arjunjono/ByteForge/ByteForge_A1_EasyEDA_DRC_Pass.png

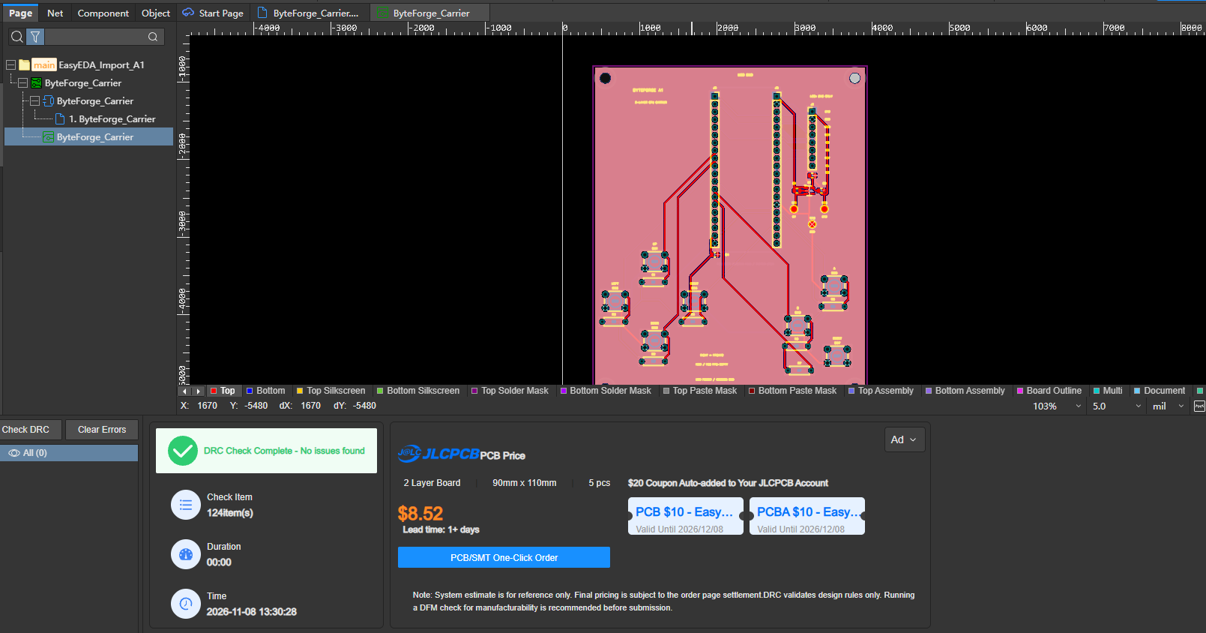
ByteForge_A1_EasyEDA_DRC_Pass.png
