arjunjono/ByteForge/ByteForge_E0_Preview.png

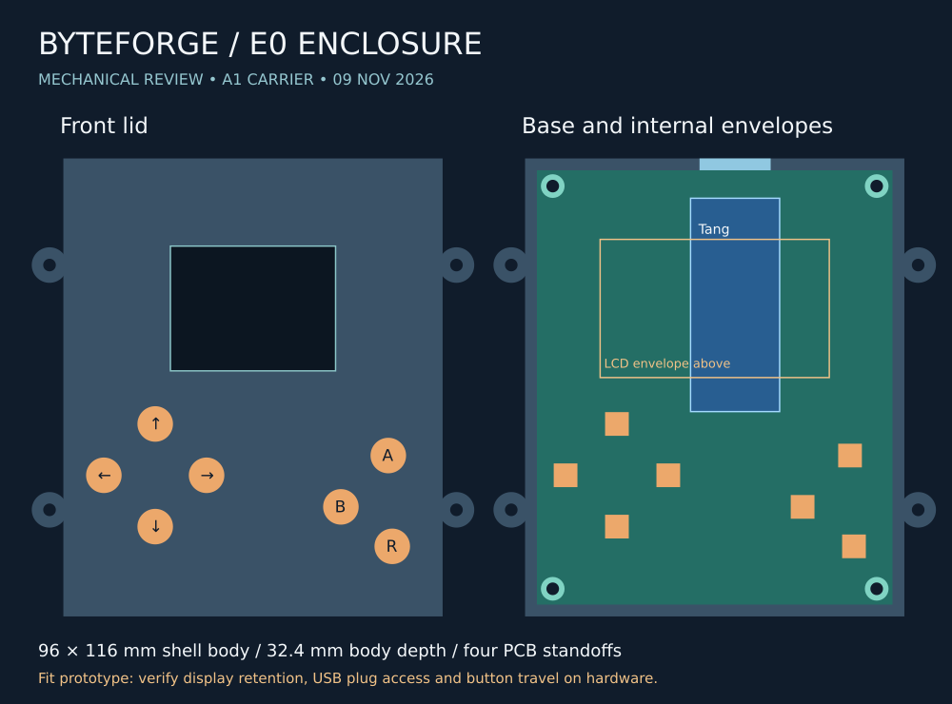
ByteForge_E0_Preview.png
