arjunjono/ByteForge/PCB_ByteForge_Carrier_2026-11-07.png

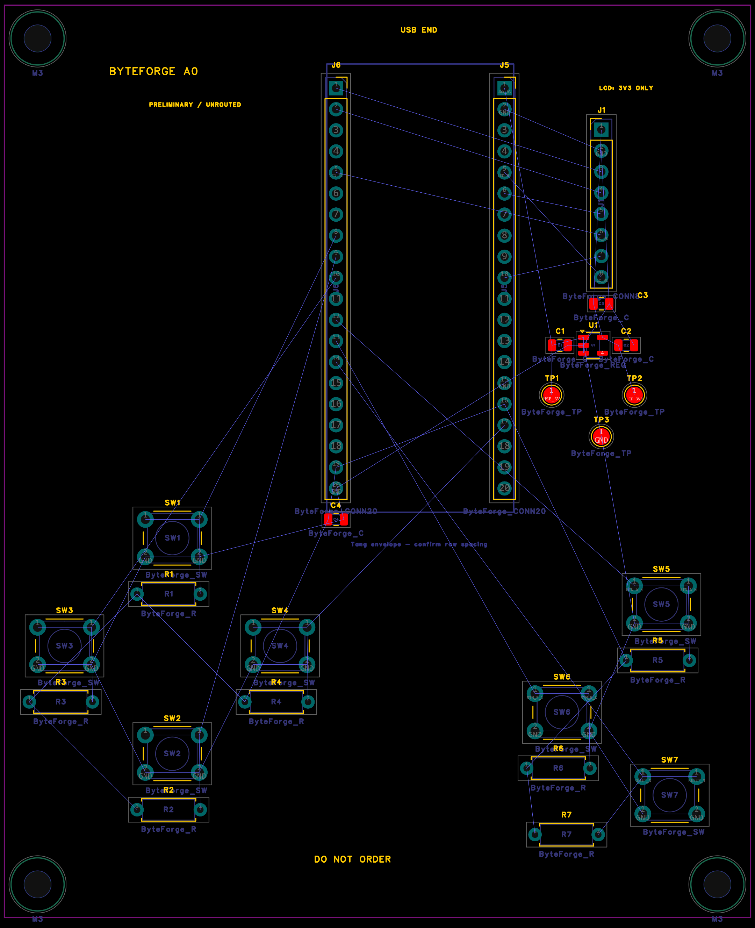
PCB_ByteForge_Carrier_2026-11-07.png
