arjunjono/ByteForge/SCH_ByteForge_Carrier_1-ByteForge_Carrier_2026-11-07.png

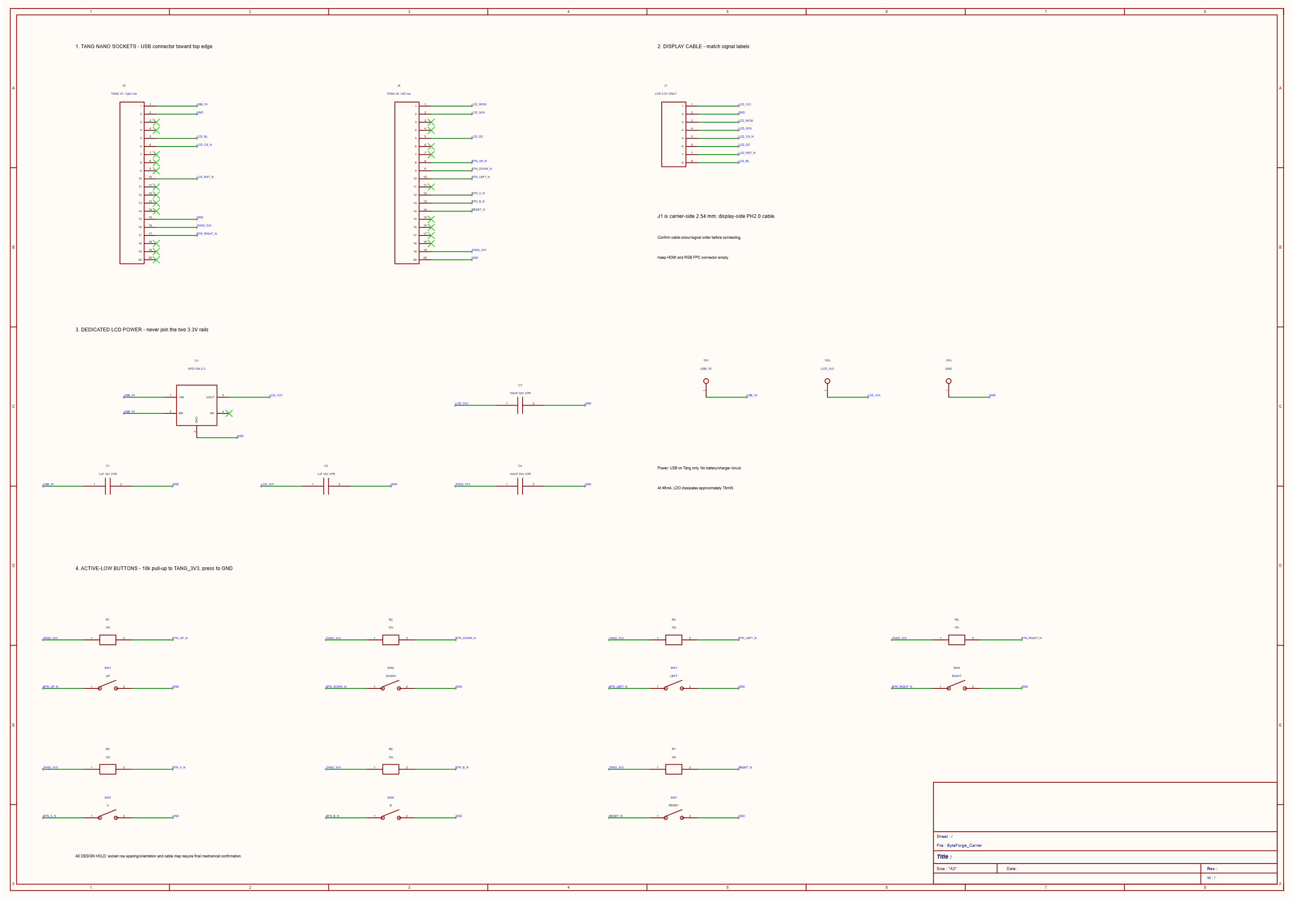
SCH_ByteForge_Carrier_1-ByteForge_Carrier_2026-11-07.png
