arjunjono/ByteForge/fpga/docs/VERIFICATION_RESULTS.md

# Verification results (what was actually run, and what was not)

Environment: Linux container, Icarus Verilog 12.0, Python 3, Yosys 0.33, nextpnr-himbaechel 9691ce8 (built from source), Apycula 0.35. 2026-10-28.

## Run and passing (simulation, Icarus `iverilog -g2012`)

| Test | Checks | Result |
|---|---|---|
| tb_program_rom (first/last address, out-of-range, no aliasing, reset retention, bus phases) | 16 435 | PASS |
| tb_io_bus (RAM boundaries/retention, unmapped, aliasing, held requests, reset in each phase, display backpressure, backlight) | 1 413 | PASS |
| tb_delay (1 ms-equivalent, 255, zero, cancellation by reset, held request) | 29 | PASS |
| tb_buttons (synchronizer latency, bounce, independence, held-at-reset) | 58 | PASS |
| tb_reset_conditioner | 11 | PASS |
| tb_spi_display HALF = 1, 2, 3 (bit order, 8 pulses, CS/DC, setup/hold, reset mid-byte, startup) | 172 each | PASS |
| tb_stack MODE 0/1/2 (stack in 0x3F00-0x3FFF, limit, underflow fault) | 12 / 264 / 6 | PASS |
| tb_board_top (pin polarity, reset button, first byte 0x36) | 14 | PASS |
| tb_demo (real CPU+ROM+RAM+peripherals, independent SPI decoder, reference init compare, 76 800 black pixels, 40x40 patch redraws per button, reset during operation twice) | 179 499 | PASS (about 2 min) |
| tb_production_timing (real 27 MHz: 270 000-clock debounce, 27 000 clocks/ms, 1 ms and 255 ms delay, 100/100/100 ms panel reset, 6.75 MHz SCLK, counter widths) | 451 | PASS (about 2 min) |
| Existing: assembler_tests.py, cpu_tb.v (15 234 checks), assembly_programs_tb.v (1 986 checks) | | PASS |

**Rerun 2026-11-07 (revision 2)**: `sim/run_all.sh` (full, without `--fast`) was run in one pass: 17 entries, `failures: 0` (log: `results/run_all_full.out`). It now (a) counts every compile failure as a failure and exits nonzero - demonstrated with a temporary syntax error in `rtl/button_input.v` (7 compile failures reported, script exit status 7, file restored by hash, clean rerun exit 0; log `results/syntax_error_demo.log`); (b) runs the UNMODIFIED `assembler_tests.py` in a scratch directory that also holds `assembler.py` and the delivered `programs/*.asm/*.hex`, so **all 78 tests run, 0 skipped**, including the three demo-program tests and the delivered-.hex comparison (the script fails if fewer than 78 run or any skip appears). The `cpu/` copies of the original files were not modified. The mutation checks were rerun: all five detected.
Limits of these results: shortened timing in tb_demo (1 "ms" = 20 clocks, debounce 200 clocks, reset phases 2 000 clocks); production-length timing is covered only by tb_production_timing (no CPU in that test). The simulated clock in tb_production_timing is 37.038 ns (1 ps rounding) so time-based checks carry about 0.003 % error; clock-count checks are exact.

## Unchanged files
SHA-256 of the six CPU files, assembler.py, assembler_tests.py, cpu_tb.v and assembly_programs_tb.v were identical before and after all work (`/hashes_before` vs after compare: identical), and `fpga/cpu/` holds byte-identical copies. No CPU correction was needed.

## Mutation checks (`sim/run_mutations.py`, temporary copies; real RTL verified unchanged)
- M1 held request completes again: detected by tb_io_bus, tb_delay.
- M2 RAM address bit 13 dropped: detected by tb_io_bus.
- M3a SPI first bit = bit 0: detected by tb_io_bus, tb_spi_display. M3b DC inverted: detected by both.
- M4 debounce bypass: detected by tb_buttons.
- An earlier version of M1 (write pulse in RDY instead of at completion) was *not* detected - it is functionally equivalent while the request is held, so it was replaced by the mutation above.
- tb_demo/tb_board_top/tb_production_timing were not re-run per mutant.

## FPGA implementation - open-source flow only (`scripts/build_oss.sh`), rerun for revision 3 (pin remap: lcd_cs 75 -> 41, lcd_rst 86 -> 48)
Tools: Yosys 0.33, nextpnr-himbaechel 9691ce8, Apycula 0.35. Commands are in `scripts/build_oss.sh` (`synth_gowin -top tang_nano_20k_top`; `nextpnr-himbaechel --device GW2AR-LV18QN88C8/I7 --vopt family=GW2A-18C --vopt cst=../../constraints/byteforge.cst --freq 27 --seed 1`; `gowin_pack -d GW2A-18C`). The previous reports and bitstream were deleted and regenerated.
- **Pins**: `results/pin_verification.txt` (regenerated by `scripts/verify_pins.py`, which `build_oss.sh` calls, into `build/oss/pin_verification.txt`) maps each placed IO site back to a package pin through Apycula's GW2AR-18C QFN88 table and compares it with the requested pin: 16 of 16 ports match, 0 mismatches, including **lcd_cs -> IOB43A -> pin 41** and **lcd_rst -> IOR49B -> pin 48** (also lcd_din 73, lcd_clk 74, lcd_dc 77, lcd_bl 42, buttons/reset 25-31, clk 4, LEDs 15/16).
- **Resources (nextpnr report)**: LUT4 1,088 used of 20,736 (the nextpnr log line "LUT4: 1300/20736" also counts pass-through LUTs), DFF 396 / 15,552, ALU 304, MUX2_LUT5/6/7/8 292/123/52/17, **BSRAM 16 / 46** (RAM and ROM inferred as block RAM), BUFG 1, IOB 16 / 384, GSR 1, rPLL 0, DSP 0. Yosys: no latches (37 "No latch inferred" messages, 0 latch cells in the netlist).
- **Timing (nextpnr static timing, seed 1, one clock `clk`/27 MHz)**: **Fmax 85.90 MHz achieved vs 27 MHz constraint - PASS** (103.05 MHz at the pre-route estimate). Critical path: control-unit instruction register -> ALU -> flags register Z flip-flop. Fmax varies with seed/tool version (earlier runs: 82.60-84.43 MHz).
- **Warnings**: Yosys 36 warnings / 5 unique: the Gowin library's block-RAM mapping `PORT_A_WR_DATA` range-select-out-of-bounds messages (from the library's `brams_map.v`, not from this design) and one ABC "network is combinational". nextpnr: no warnings; informational "Cell O_sdram_* not found" lines (no SDRAM is used).
- **Bitstream**: `build/oss/byteforge.fs` regenerated by `gowin_pack`, sha256 3eec9fcf...14d5. **Never loaded on hardware.**
- **Unconstrained / not analysed**: nextpnr's SDC reader rejected parts of `byteforge.sdc`, so the run uses `--freq 27` only. The narrow input-port false paths (buttons, reset) were not applied and no input/output delay or external I/O timing was analysed. Gowin's own timing tool was not run.

## Source checks done in revision 2 (see docs/SECTION22_23_CORRECTIONS.md)
- ST7789V v1.6 datasheet section 9.1.12 read on screen: >= 5 ms before the next command after SLPOUT; 120 ms applies before SLEEP IN. The demo's 125 ms wait is conservative, not required. Reset timing section 7.4.5 NOT read.
- Waveshare 2inch LCD Module schematic opened visually (structure only: no regulator/level shifter symbol; revision not legible); wiki: 3.3 V examples, 46 mA.
- Sipeed Tang Nano 20K schematic (Rev 1.30 distributor copy): net labels read from text; browser view too low-resolution for net-level reading. Pin 42's bank voltage remains unconfirmed; pins 73/74/75/86 carry HSPI/SYS_LED net names (possible BL616 sharing) - open risk.
- (Superseded by the revision 3 rerun above.)

## NOT VERIFIED
- Gowin IDE synthesis, place-and-route, timing report and resource report (Gowin EDA is not available here). Whether Gowin honours `syn_preserve`, `syn_ramstyle`, `$readmemh` path resolution and `initial` register values: unknown.
- Anything on hardware: display function and orientation, backlight polarity/bank-4 level, pin voltages, button wiring, the 125 ms post-SLPOUT delay, 6.75 MHz SPI on the real module, power-up behaviour.
- The Windows build steps and EDA Playground instructions were written but not executed.
- The Waveshare schematic was read from a text netlist dump, not visually.

## Revision 3 regression (pin remap only)
The RTL, CPU files and assembly program were not changed; only the constraints, comments and documentation. After the remap `run_all.sh --fast` gave `failures: 0` (assembler_tests 78 run / 0 skipped, existing cpu_tb and assembly_programs_tb pass), `build_rom.py --check` reported demo.hex, demo.lst and byteforge_rom.hex identical, and the original files' hashes are unchanged. tb_demo, tb_production_timing and the mutation checks were not rerun for this revision because no RTL or ROM changed (their last passing results are those listed above).
