arjunjono/ByteForge/ByteForge_A1_Verification.png

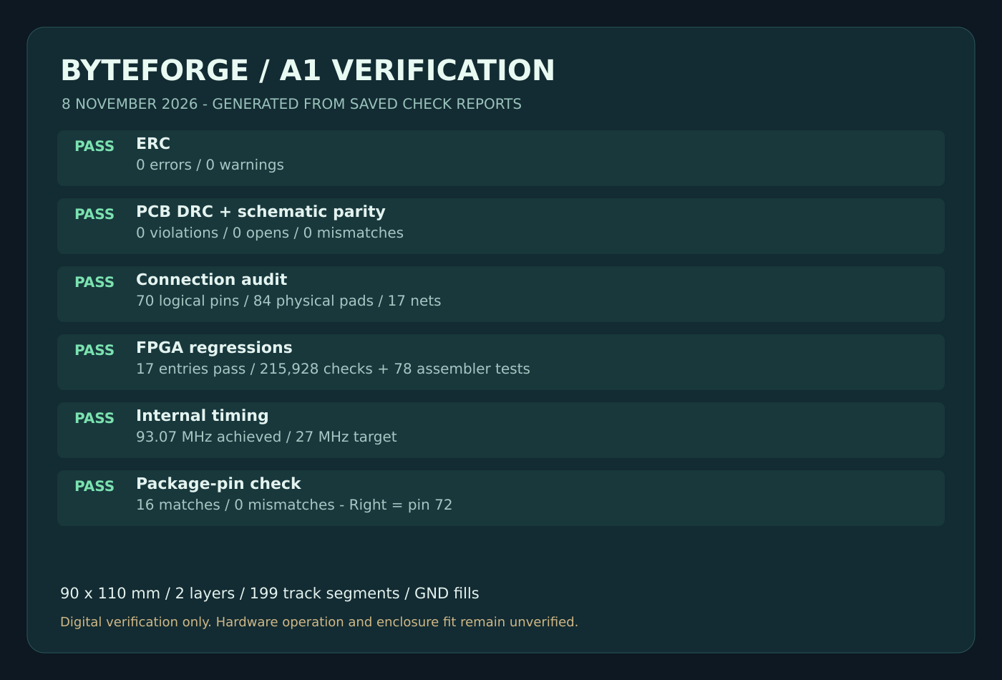
ByteForge_A1_Verification.png
