arjunjono/ByteForge/ByteForge_ALU_Test_Results.png

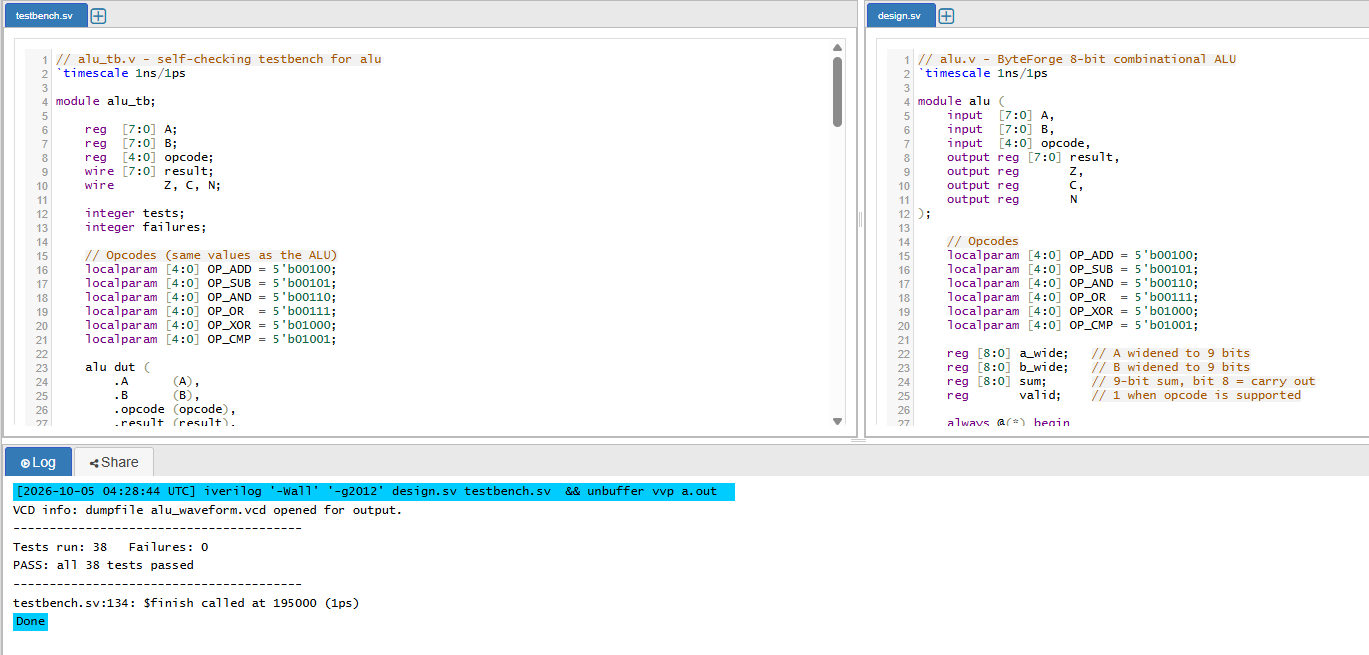
ByteForge_ALU_Test_Results.png
