arjunjono/ByteForge/ByteForge_Assembly_Program_Test_Results.png

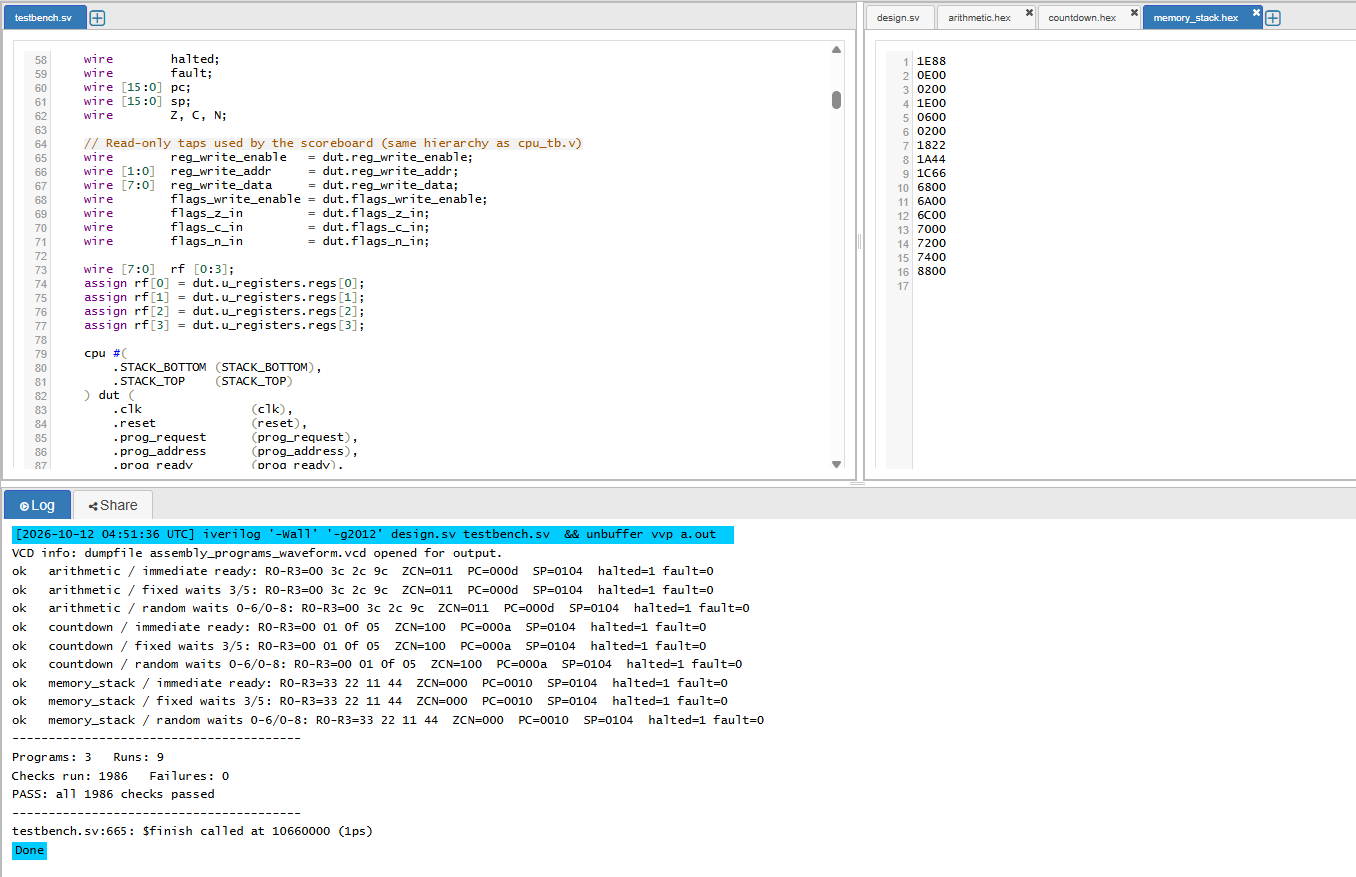
ByteForge_Assembly_Program_Test_Results.png
