arjunjono/ByteForge/ByteForge_Control_Unit_Test_Results.png

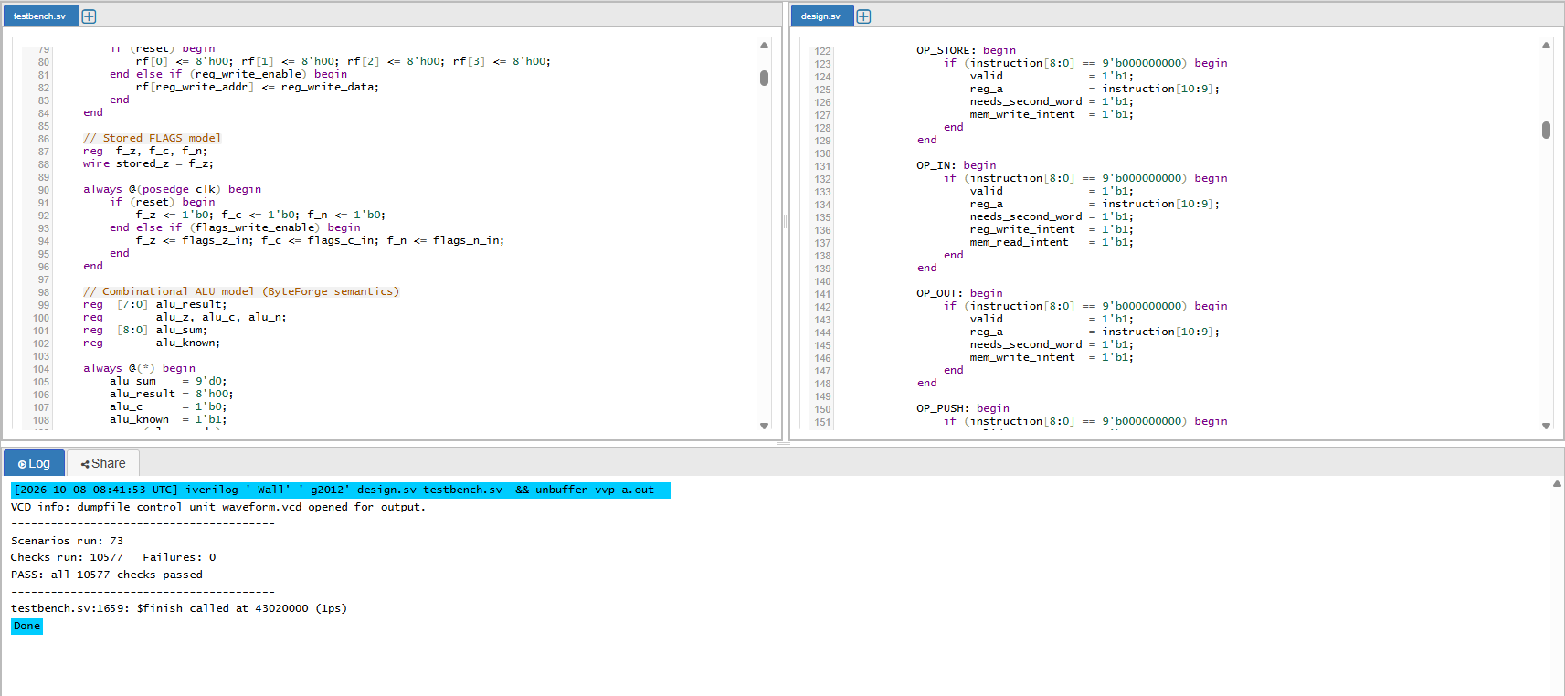
ByteForge_Control_Unit_Test_Results.png
