arjunjono/ByteForge/ByteForge_CPU_Test_Results.png

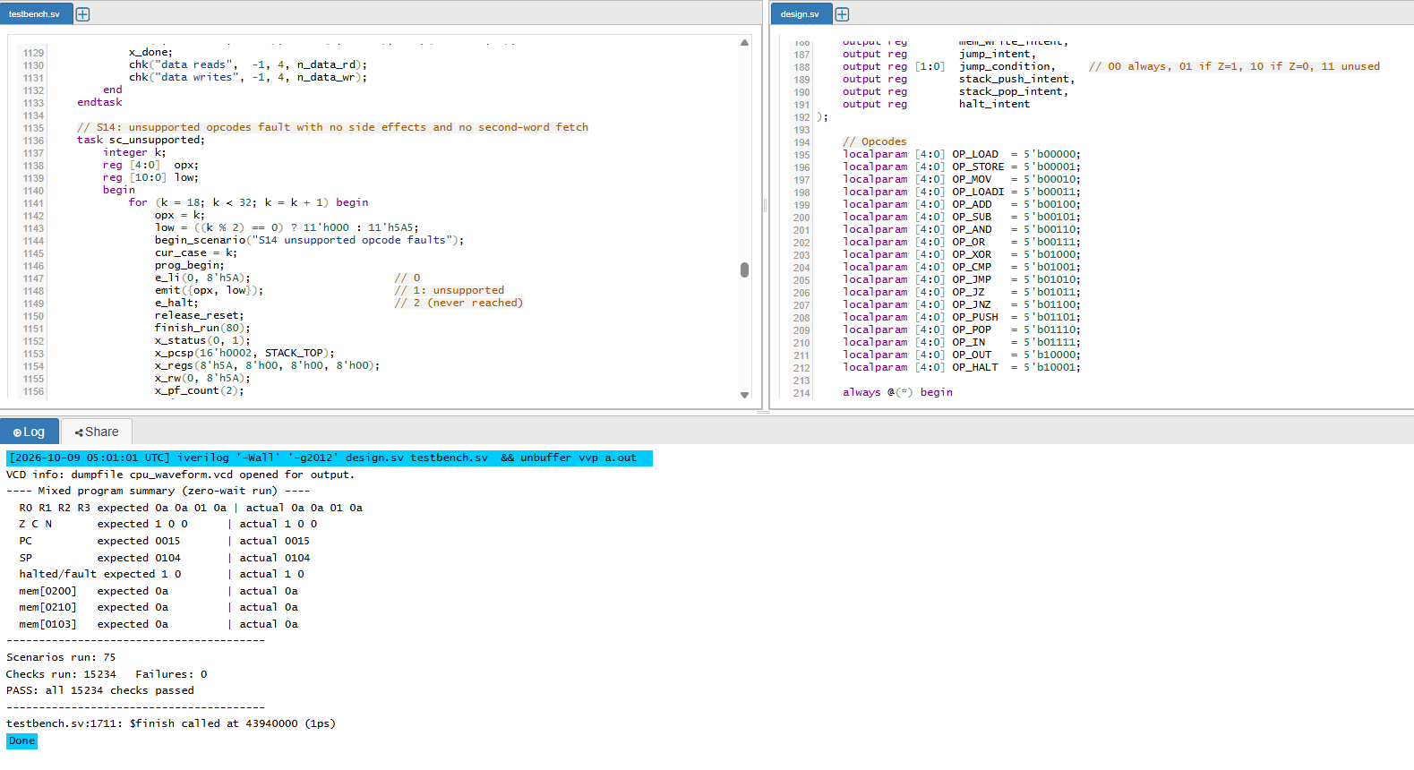
ByteForge_CPU_Test_Results.png
