arjunjono/ByteForge/ByteForge_Decoder_Test_Results.png

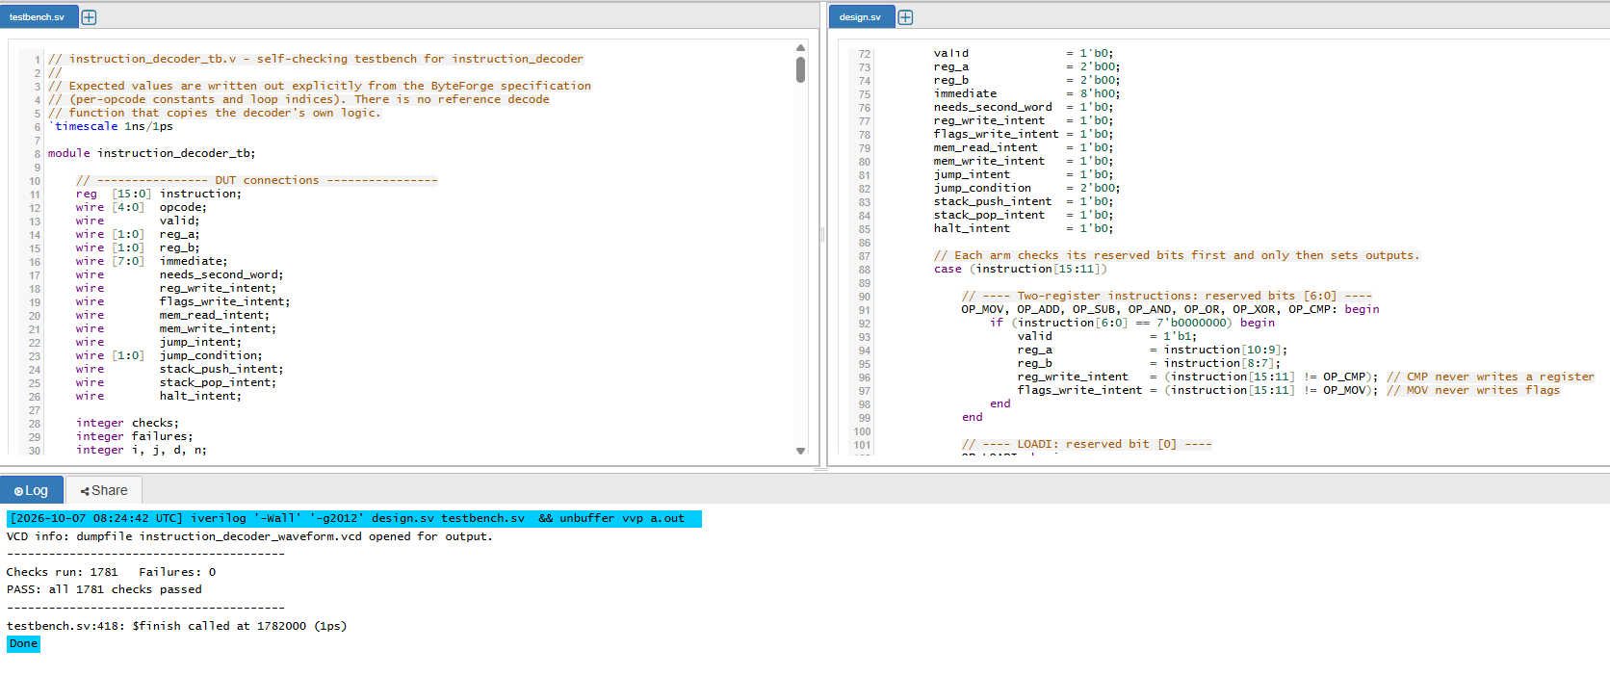
ByteForge_Decoder_Test_Results.png
