arjunjono/ByteForge/ByteForge_FPGA_Test_Results.png

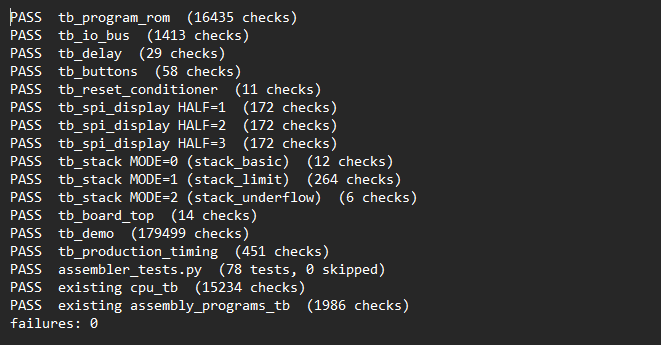
ByteForge_FPGA_Test_Results.png
