arjunjono/ByteForge/ByteForge_FPGA_Timing_Results.png

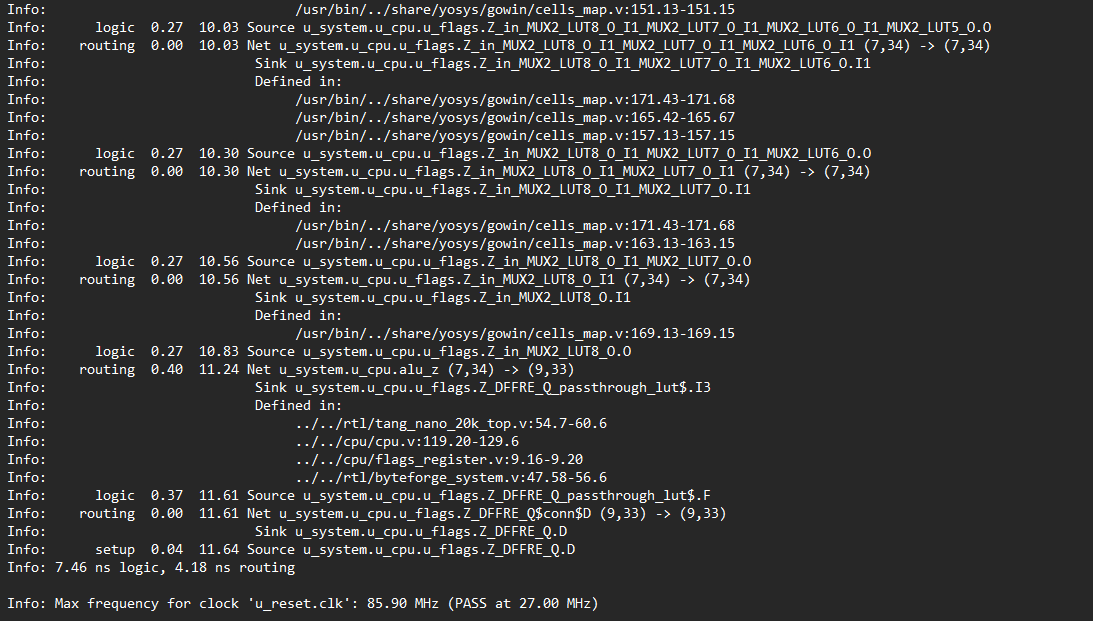
ByteForge_FPGA_Timing_Results.png
