arjunjono/ByteForge/ByteForge_Registers_Test_Results.png

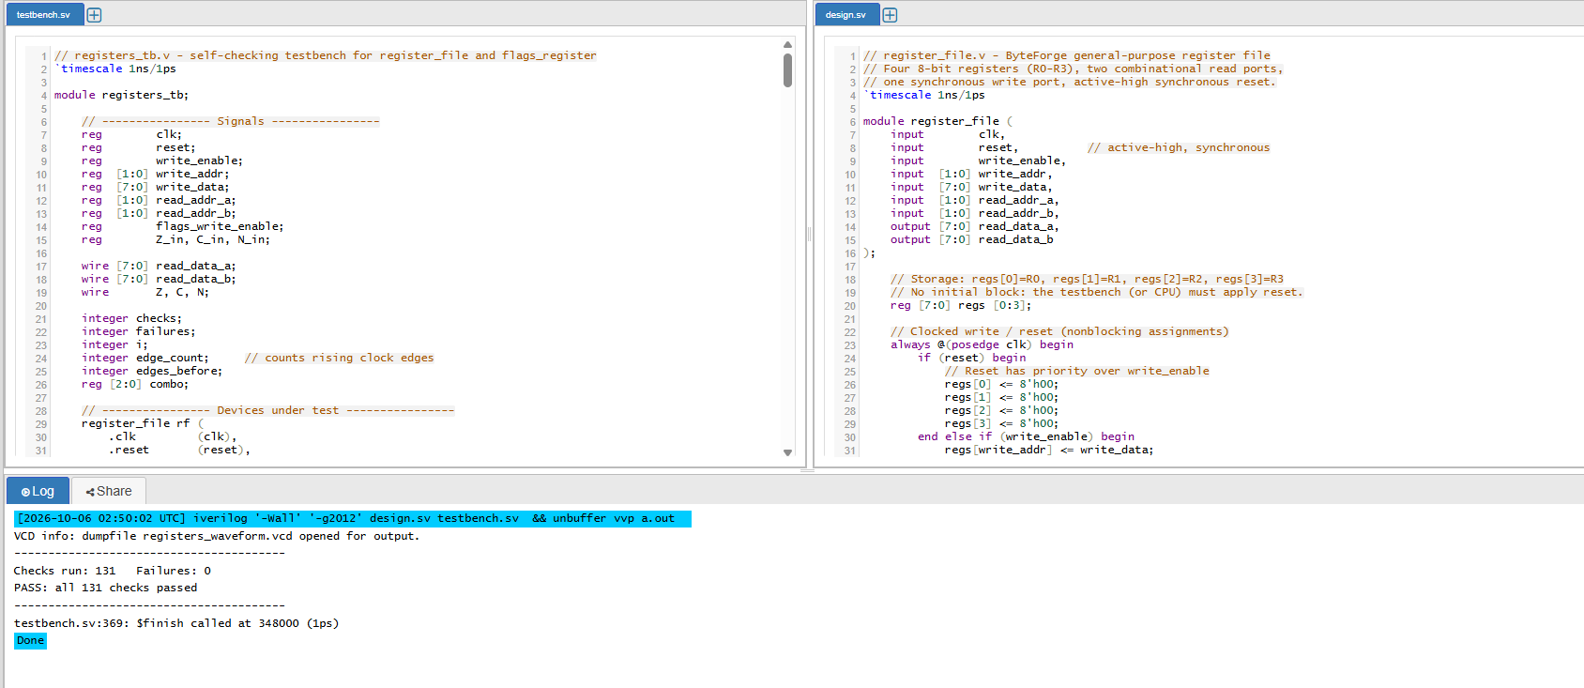
ByteForge_Registers_Test_Results.png
