arjunjono/ByteForge/Design_Review/Verification/ByteForge_Entry15_Journal.png

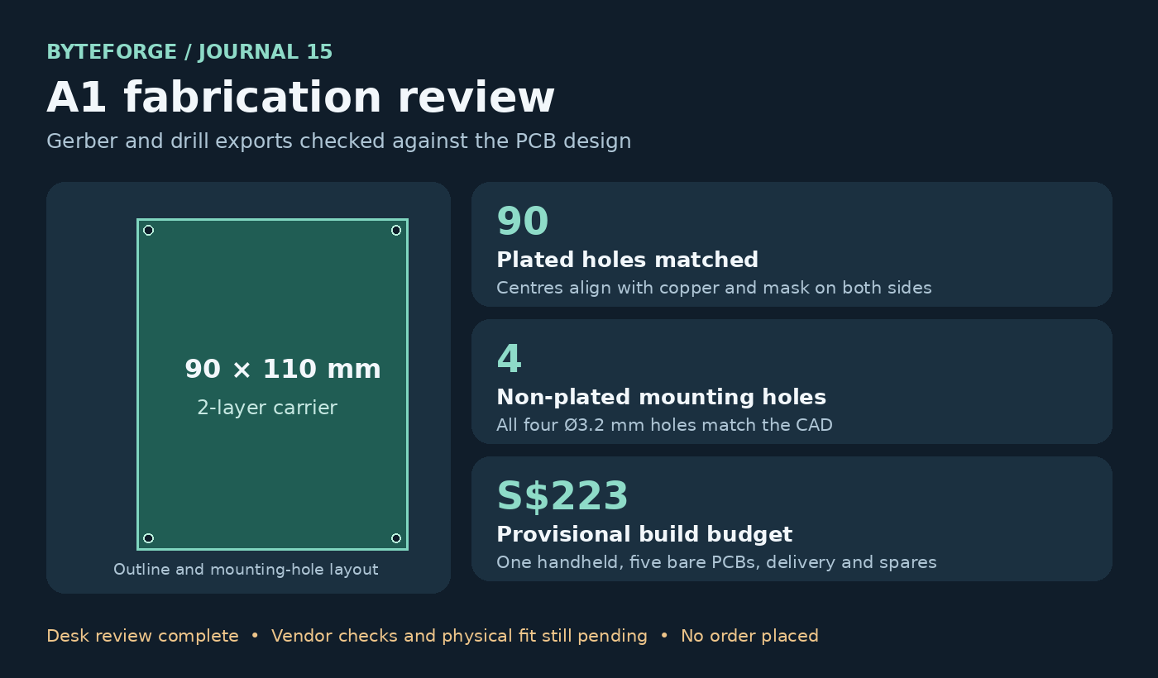
Design_Review/Verification/ByteForge_Entry15_Journal.png
