arjunjono/ByteForge/Design_Review/PCB/ByteForge_Carrier.kicad_pcb

## KiCad design Design_Review/PCB/ByteForge_Carrier.kicad_pcb (2026-11-09)

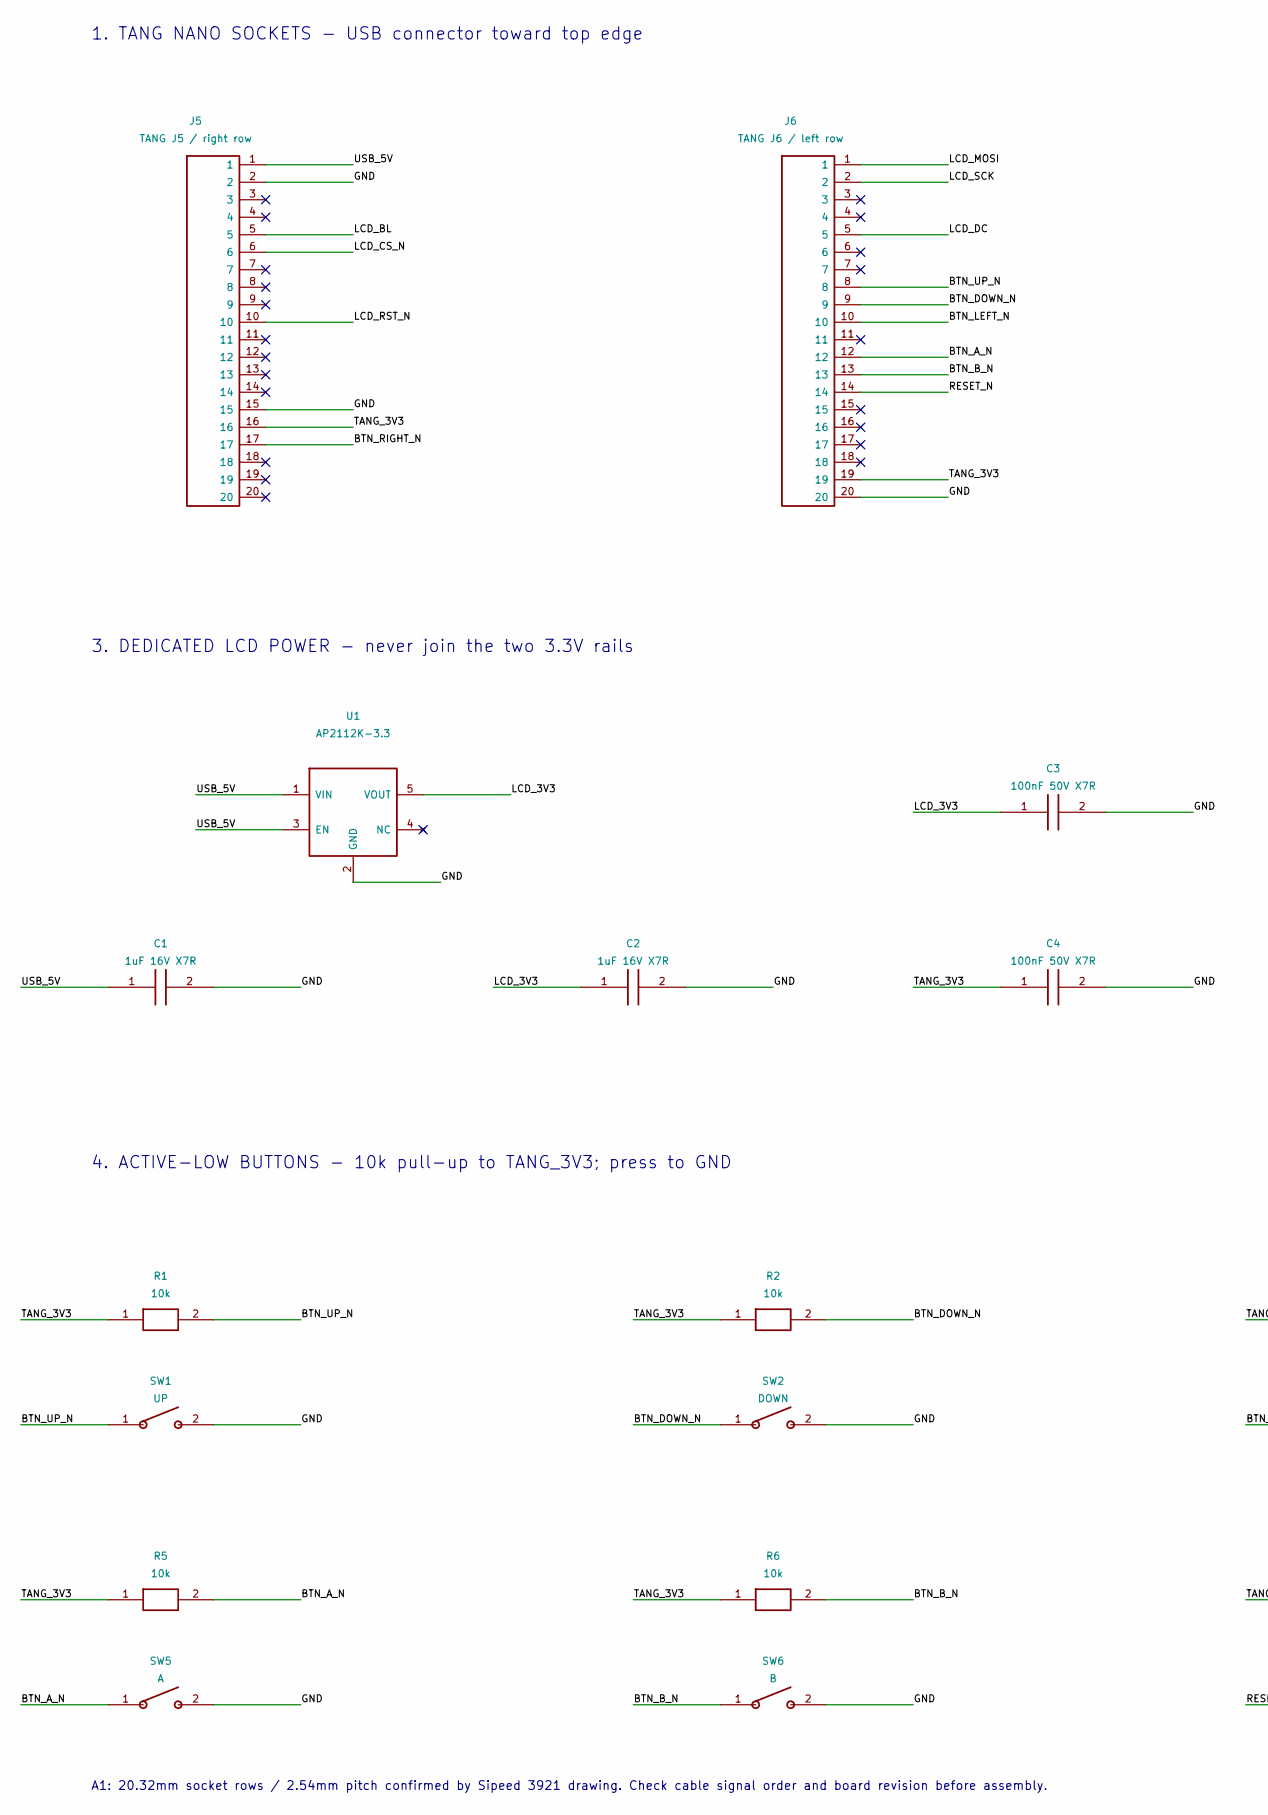
[picture p19: schematic ByteForge_Carrier.kicad_sch, ByteForge carrier - routed review build, part in row 1, column 1]

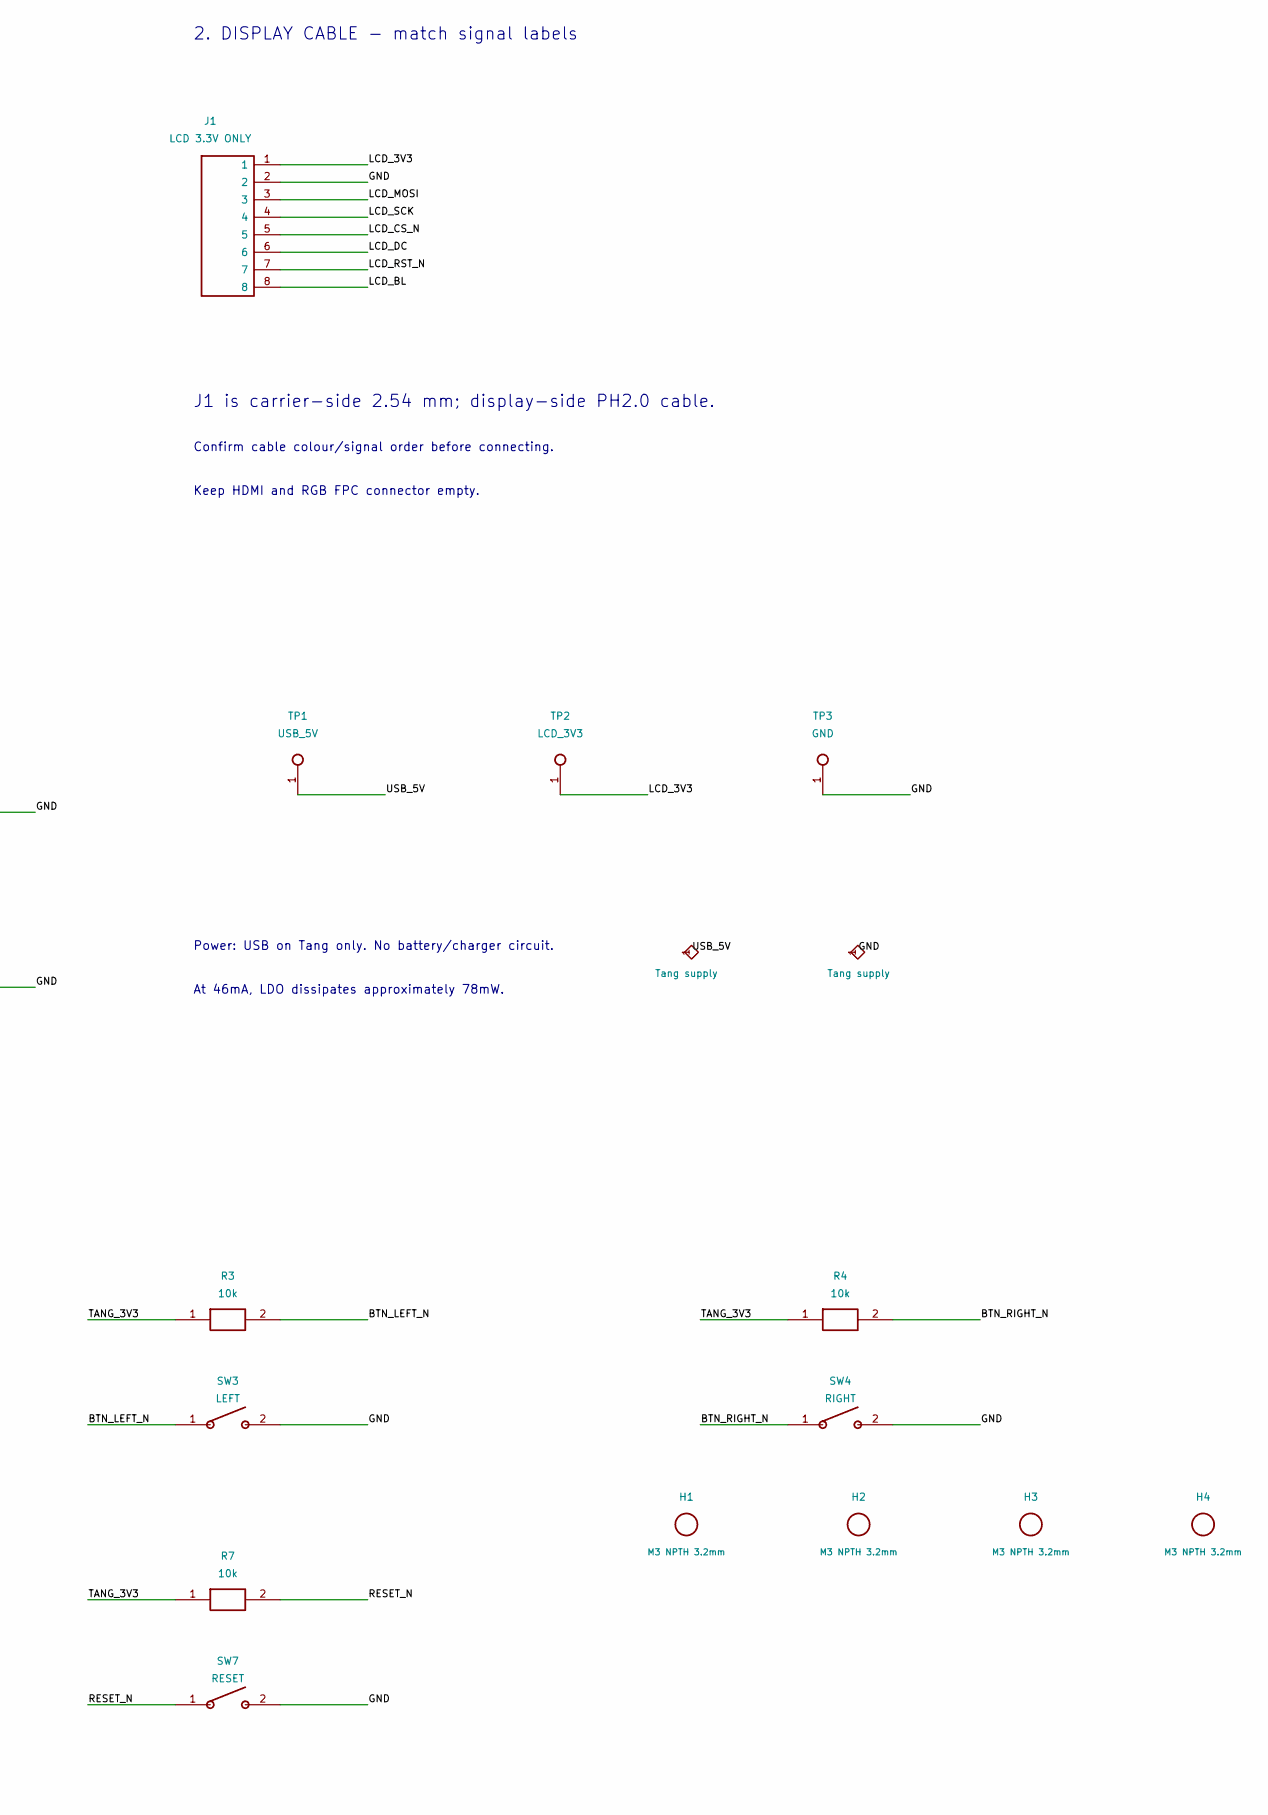
[picture p20: schematic ByteForge_Carrier.kicad_sch, ByteForge carrier - routed review build, part in row 1, column 2]

Parts:
C1, C2: 1uF 16V X7R; C_0805_2012Metric
C3, C4: 100nF 50V X7R; C_0805_2012Metric
H1, H2, H3, H4: M3 NPTH 3.2mm; MountingHole_3.2mm_M3
J1: LCD 3.3V ONLY; PinHeader_1x08_P2.54mm_Vertical
J5: TANG J5 / right row; PinSocket_1x20_P2.54mm_Vertical
J6: TANG J6 / left row; PinSocket_1x20_P2.54mm_Vertical
R1, R2, R3, R4, R5, R6, R7: 10k; R_Axial_DIN0207_L6.3mm_D2.5mm_P7.62mm_Horizontal
SW1: UP; SW_PUSH_6mm
SW2: DOWN; SW_PUSH_6mm
SW3: LEFT; SW_PUSH_6mm
SW4: RIGHT; SW_PUSH_6mm
SW5: A; SW_PUSH_6mm
SW6: B; SW_PUSH_6mm
SW7: RESET; SW_PUSH_6mm
TP1: USB_5V; TestPoint_Pad_D2.0mm
TP2: LCD_3V3; TestPoint_Pad_D2.0mm
TP3: GND; TestPoint_Pad_D2.0mm
U1: AP2112K-3.3; SOT-23-5

Connections:
/BTN_A_N: J6.12, R5.2, SW5.1
/BTN_B_N: J6.13, R6.2, SW6.1
/BTN_DOWN_N: J6.9, R2.2, SW2.1
/BTN_LEFT_N: J6.10, R3.2, SW3.1
/BTN_RIGHT_N: J5.17, R4.2, SW4.1
/BTN_UP_N: J6.8, R1.2, SW1.1
/GND: C1.2, C2.2, C3.2, C4.2, J1.2, J5.2, J5.15, J6.20, SW1.2, SW2.2, SW3.2, SW4.2, SW5.2, SW6.2, SW7.2, TP3.1, U1.2 (GND)
/LCD_3V3: C2.1, C3.1, J1.1, TP2.1, U1.5 (VOUT)
/LCD_BL: J1.8, J5.5
/LCD_CS_N: J1.5, J5.6
/LCD_DC: J1.6, J6.5
/LCD_MOSI: J1.3, J6.1
/LCD_RST_N: J1.7, J5.10
/LCD_SCK: J1.4, J6.2
/RESET_N: J6.14, R7.2, SW7.1
/TANG_3V3: C4.1, J5.16, J6.19, R1.1, R2.1, R3.1, R4.1, R5.1, R6.1, R7.1
/USB_5V: C1.1, J5.1, TP1.1, U1.1 (VIN), U1.3 (EN)

Notes on the sheet:
1. TANG NANO SOCKETS - USB connector toward top edge
2. DISPLAY CABLE - match signal labels
J1 is carrier-side 2.54 mm; display-side PH2.0 cable.
Confirm cable colour/signal order before connecting.
Keep HDMI and RGB FPC connector empty.
3. DEDICATED LCD POWER - never join the two 3.3V rails
Power: USB on Tang only. No battery/charger circuit.
At 46mA, LDO dissipates approximately 78mW.
4. ACTIVE-LOW BUTTONS - 10k pull-up to TANG_3V3; press to GND
A1: 20.32mm socket rows / 2.54mm pitch confirmed by Sipeed 3921 drawing. Check cable signal order and board revision before assembly.

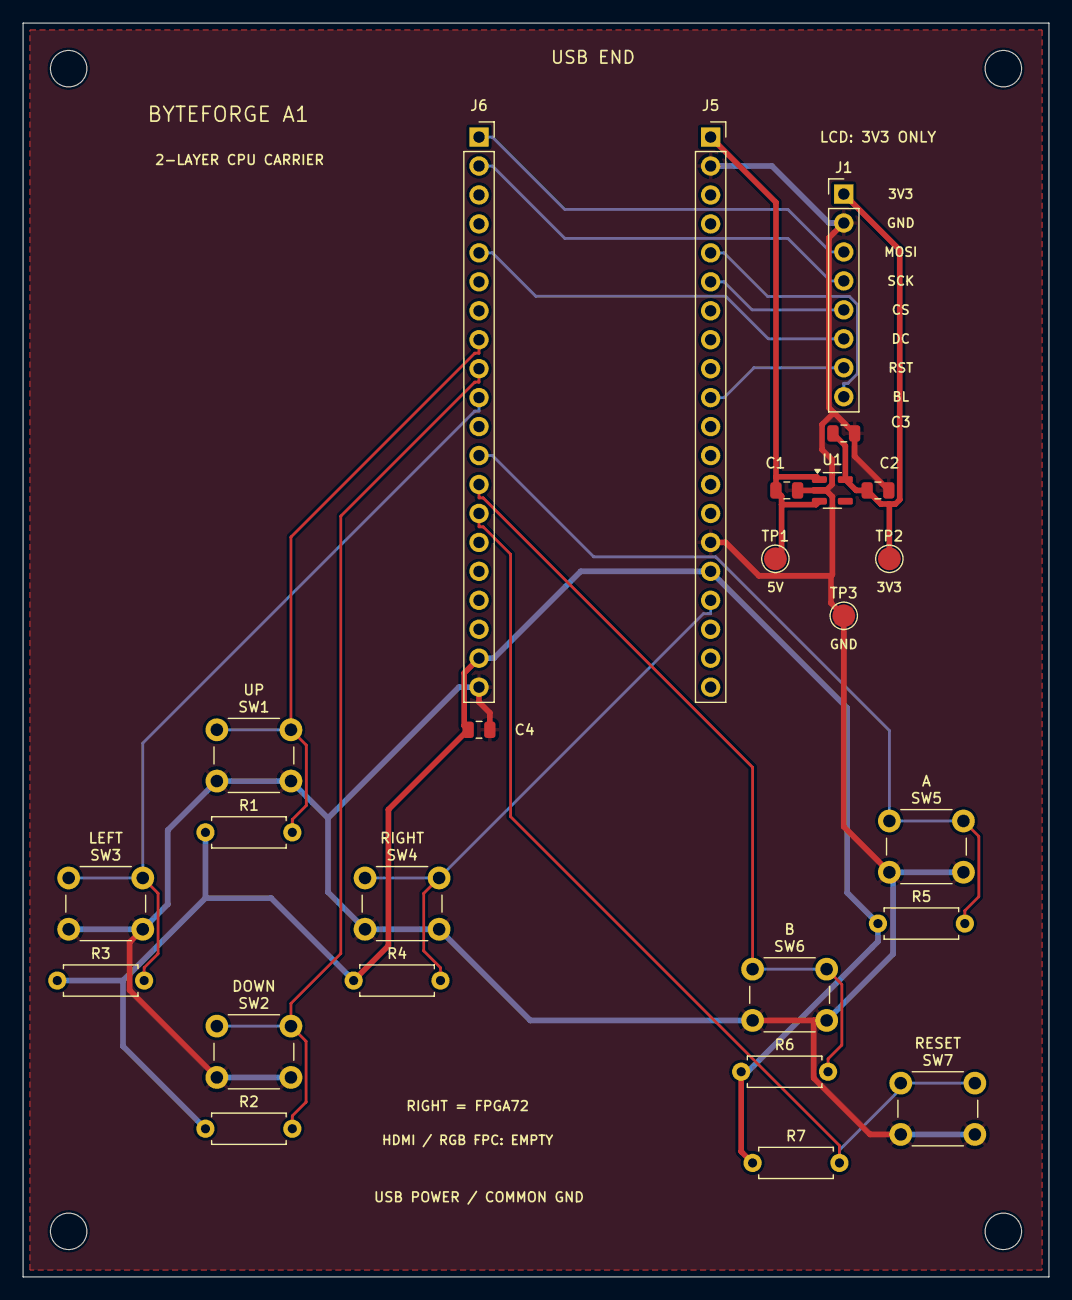
[picture p21: board ByteForge_Carrier.kicad_pcb from above]

Board: 2 copper layers, 90.0 x 110.0 mm, 29 parts (0 on the bottom side), 17 nets.
