arjunjono/ByteForge/(commit log)

2026-10-08 Added the ByteForge CPU components developed and tested so far:
    - alu.v and alu_tb.v: 8-bit arithmetic and logic unit supporting ADD, SUB, AND, OR, XOR and CMP, with Zero, Carry and Negative flags. All 38 test cases passed.
    - register_file.v, flags_register.v and registers_tb.v: Four writable 8-bit registers, two combinational read ports, independent FLAGS storage and synchronous reset. All 131 checks passed.
    - instruction_decoder.v and instruction_decoder_tb.v: Decodes 16-bit instruction words, extracts operands, identifies two-word instructions and rejects unsupported opcodes or invalid reserved bits. All 1,781 checks passed.
    - control_unit.v and control_unit_tb.v: Coordinates ins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
    [alu.v, alu_tb.v, control_unit.v, control_unit_tb.v, flags_register.v, instruction_decoder.v, instruction_decoder_tb.v, register_file.v]
2026-10-09 Integrate CPU core and verify 75 test scenarios
    Add cpu.v to connect the ALU, register file, FLAGS register and control unit into the ByteForge CPU core.
    Add cpu_tb.v for integration testing. The EDA Playground simulation passed all 75 scenarios and 15,234 checks with zero failures.
    Include the CPU test results screenshot and architecture document v8 with Section 19 documenting the integration and simulation results.
    [cpu.v, cpu_tb.v]
2026-10-12 Add assembler and verify assembly programs on CPU core
    Add the Python assembler, its test suite and three demonstration programs with generated machine code and listings.
    Add an end-to-end testbench that loads the assembled programs and runs them using the existing CPU modules with immediate, fixed-delay and random-delay memory responses.
    All 78 Python tests passed. The EDA Playground simulation completed nine runs and 1,986 checks with zero failures.
    Include architecture document v9 and the assembly program test results screenshot.
    Saved simulation: https://edaplayground.com/x/fee2
    [assembler.py, assembler_tests.py, assembly_programs_tb.v]
2026-10-25 Document hardware selection, budget and connection plan
    Add architecture document v10 with Section 22 covering the proposed Tang Nano 20K FPGA module, Waveshare display, buttons, USB power and custom carrier PCB.
    Document proposed FPGA pin assignments and a preliminary US$207.10 budget. Add the hardware connection diagram.
    Final supplier pricing, FPGA synthesis, timing analysis and physical testing remain outstanding.
2026-11-07 Integrate FPGA system and verify updated pin assignments
    Add the FPGA system with program ROM, data RAM, debounced buttons, reset conditioning, delay peripheral and SPI display controller.
    Include the assembly demo, testbenches, build scripts, constraints and verification reports.
    Correct display CS to pin 41 and RST to pin 48, and document the separate 3.3 V display supply.
    Simulation regressions passed. The updated open-source FPGA build reports 85.90 MHz against the 27 MHz target, using 16 of 46 block RAMs.
    Include architecture document v11 and test/timing screenshots. Physical hardware operation and external display timing remain unverified.
    [alu.v, assembler.py, assembler_tests.py, assembly_programs_tb.v, button_input.v]
2026-11-08 Add carrier schematic and initial PCB placement
    Upload the carrier design ZIP, schematic and PCB images, and architecture document updated through Section 25.
    Include the display power circuit, seven button inputs, module sockets, mounting holes and proposed Right-button remap from FPGA pin 26 to pin 72.
    Document EasyEDA import corrections and connection checks. PCB routing, mechanical confirmation and FPGA implementation with the updated constraints remain pending.
2026-11-08 Add routed A1 carrier and verified EasyEDA project
    Add the routed two-layer A1 carrier, editable EasyEDA project, schematic and routing images, and verification reports.
    Resolve EasyEDA import and copper-clearance issues, with the final DRC reporting no issues. Update FPGA constraints to use pin 72 for the Right button and include the updated architecture documentation.
    Hardware operation and enclosure fit remain unverified.
2026-11-09 Add E0 enclosure prototype for the A1 carrier
    Add editable enclosure CAD, STL exports, and a layout preview for the A1 carrier. Display retention, USB plug clearance, and button travel still need physical fit checks.
2026-11-09 Add Entry 15 review and E1 STEP assembly
    Add the A1 fabrication review, provisional S$223 budget, and E1 STEP assembly package with preview images.
2026-11-09 Organize ByteForge design review files
    Update the README and add a linked BOM with the provisional S$223 budget. Collect the A1 PCB files, E1 STEP assembly, LCD wiring diagram, and verification results in Design_Review.
    [BOM.csv, ByteForge_Carrier.kicad_pcb, ByteForge_Carrier.kicad_sch, FPGA_Pin_Map.csv]
